0hmX/am3352-ddr-track-a-local-dfm-wip-20261007/docs/pcb-preview.png

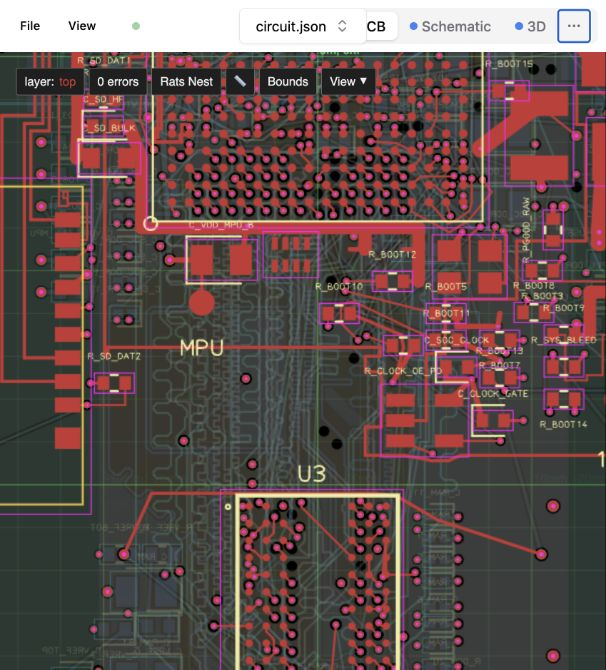
docs/pcb-preview.png
