0hmX/am3352-ddr-track-a-local-dfm-wip-20261007/README.md

# AM3352 DDR3 and RGB888 HDMI

This is a native tscircuit board with **251/251 named nets connected** (routing WIP; see limitations below). The active board is `index.tsx`; files in `layout/` and `data/` also include historical route sets, so presence does not imply a set is mounted. See the [251-net checkpoint](docs/routing-251-checkpoint.md), the prior [245-net checkpoint](docs/routing-245-checkpoint.md) and [validation summary](docs/routing-245-validation.json).

## Development

```sh
bun install --frozen-lockfile
bun run dev
```

Open `http://localhost:3020/#file=index.tsx&tab=pcb`. `bun run build` creates the site in ignored `dist/`. Functional subcircuit group boxes are organizational boundaries, not physical keepouts.

## DDR simulation

```sh
tsci simulate simulate.circuit.tsx     # or: bun run simulate
```

This runs the byte-0 DQ0 write simulation on the real board in about 4 minutes. It goes through FastHenry, FasterCap, the vendor IBIS models and ngspice, then writes the report, with the eye diagram, to `.tscircuit/simulation-simulate-<time>/results.html`. Open it and choose **Plots → Eye**.

**Before the first run,** place the two vendor IBIS files in `simulations-next/model-review/`: `sprm552c-candidate-models.ibs` (TI) and `W631GG6MB-12.ibs` (Winbond). They aren't distributed with this repo. Their source URLs and SHA-256 hashes are in `simulations-next/model-review/review-receipt.json`.

The result is DQ0 alone with an ideal strobe, not a byte-0 verdict. What is and isn't modeled: [simulations-next/README.md](simulations-next/README.md).

## Routing requirements and limitations

Keep processor and DDR memory placement fixed. Use actual component-pad-centered signal transitions and deliberate straight/45-degree routing. DDR point-to-point routes have at most two physical signal vias including endpoint escapes; ground stitches are separate. Preserve true pad positions and exact resistor-channel mappings. Bounded local spacing decisions do not waive physical shorts or same-depth drill clearance.

Validate the composed board with native continuity, clearance, placement and trace-style checks, then independently reparse emitted Gerber/Excellon connectivity, shorts, drill spans and reference coverage. Preserve prior connections and keep inherited findings visible.

All 46 DDR timing routes are connected, but 10 DDR reference-area findings and additional low margins remain. Board-wide via-in-pad compliance is incomplete: three signal midpoints and nine off-pad power joins remain. The actual fabrication stack, configured DDR rate, impedance, timing and current capacity are unverified. Filled/capped via-in-pad processing and blind/buried layer construction require fabricator qualification. RAM power retains capacitor-barrel dependencies. This is routing WIP, not a fabrication release or SI/PI/boot signoff.

The cloud checkpoint does not include offline Mac work. The prior [240-net snapshot](docs/routing-240-snapshot.md) is historical.

The SYSBOOT6 increment uses a reviewed V1V8 feed redistribution. Its capacitor-barrel dependencies remain open power-capacity limitations. See the current [routing TODO](docs/routing-todo.md).

SD clock relief: [native TSX detours and checks](docs/through-vias/sd-clock-relief-increment.md)
leave **572 non-through vias**; all 686 native connectivity entries remain connected.

CPU-area ground simplification: [four redundant pad barrels removed in native TSX](docs/through-vias/cpu-ground-pad-removal-increment.md)
leaves **568 non-through vias**, with unchanged trace copper and verified connectivity.

CPU-area ground links: [28 native surface links replace blind pad barrels](docs/through-vias/cpu-ground-surface-increment.md)
leave **540 non-through vias**, preserving every original trace centerline and verified connectivity.

CPU V3V3 feeds: [seven blind barrels replaced by native surface links](docs/through-vias/cpu-v3-surface-increment.md)
leave **533 non-through vias**; the C_IO1_0 bridge is retained and all connectivity checks pass.

DDR-area ground links: [seven blind pad vias replaced by native surface links](docs/through-vias/ddr-ground-surface-increment.md)
leave **526 non-through vias**, with fixed DDR placement and verified native/exported connectivity.

CPU surface ground: [checked native fills and 68 pad-via removal candidates](docs/through-vias/cpu-surface-ground-increment.md).
This groundwork retains **526 non-through vias**; actual removal is a separate stacked increment.

CPU pad-via removal: [68 blind barrels and 28 redundant ground links removed in native TSX](docs/through-vias/cpu-surface-pad-removal-increment.md)
leaves **458 non-through vias**, with all native/exported nets and post-drill ground terminals connected.

DDR surface ground: [native pours replace thirteen more blind pad vias](docs/through-vias/ddr-surface-pad-removal-increment.md)
leaves **445 non-through vias**; native and exported connectivity and actual post-drill ground continuity pass.

CPU auxiliary ground: [nineteen unused pad-free stitches removed in native TSX](docs/through-vias/cpu-aux-ground-removal-increment.md)
leaves **426 non-through vias**, with unchanged trace copper and verified connectivity.

DDR BGA escapes: [four nearby through columns with native TSX links](docs/through-vias/ddr-endpoint-nudges-increment.md)
leave **422 non-through vias**, preserving all original route centerlines and verified connectivity.

CPU peripheral ground: [wider native fills replace nineteen more blind pad vias](docs/through-vias/cpu-peripheral-pad-removal-increment.md)
leaves **403 non-through vias**, with unchanged trace copper and verified connectivity.

Ethernet relief: [ten auxiliary stitches removed and two endpoint barrels moved through in TSX](docs/through-vias/ethernet-through-relief-increment.md)
leaves **391 non-through vias**, with all original route centerlines preserved and connectivity verified.

DDR memory escapes: [DQS0 and BA2 gain through columns at memory in native TSX](docs/through-vias/ddr-memory-endpoints-increment.md)
leave **389 non-through vias**, preserving original route centerlines and verified connectivity; added lengths remain unqualified.

CPU pad columns: [24 native TSX through columns and short surface links](docs/through-vias/cpu-pad-through-columns-increment.md)
leave **274 non-through vias**, preserving all existing connections and fixed placements.

DDR_BA1 relief: [a native TSX through column with a 0.070711 mm nudge](docs/through-vias/ddr-ba1-through-column-increment.md)
leaves **273 non-through vias**, with all native/exported connections preserved.

CPU manual columns: [nine through vias and native power/USB links](docs/through-vias/cpu-manual-through-columns-increment.md)
leave **264 non-through vias**, with fixed placements and verified native/exported connectivity.

Peripheral pad columns: [27 native through columns and short surface links](docs/through-vias/peripheral-pad-through-columns-increment.md)
leave **237 non-through vias**, with fixed placements and all connections preserved.

DDR byte-1 relief: [two original CPU pad columns become through via a native Bottom detour](docs/through-vias/ddr-byte1-through-relief-increment.md)
leaves **235 non-through vias**, preserving both DDR paths and all connected nets.

Board surface Ground: [nine blind pad barrels removed with native surface fills](docs/through-vias/board-ground-pad-removal-increment.md)
leaves **226 non-through vias**, with all trace copper unchanged and connectivity verified after removal.
