0hmX/am3352-ddr-track-a-local-dfm-wip-20261007/docs/schematic-visual/before/cpu-power.png

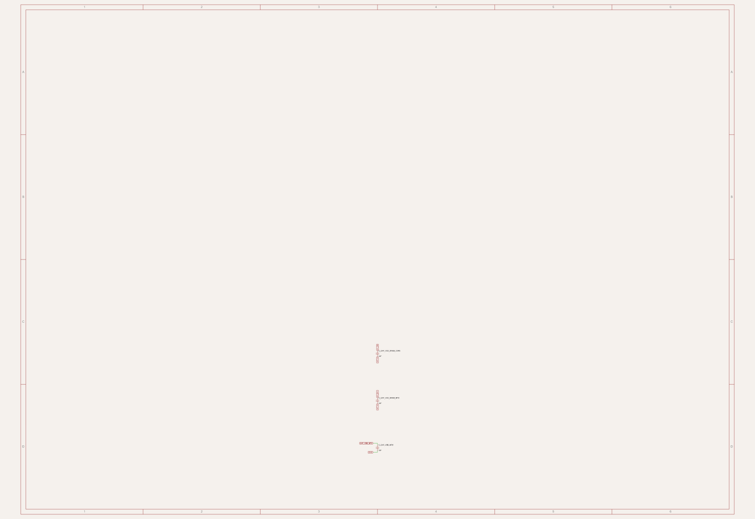
docs/schematic-visual/before/cpu-power.png
