0hmX/am3352-ddr-track-a-local-dfm-wip-20261007/docs/schematic-visual/before/ethernet-and-rgb-expansion.png

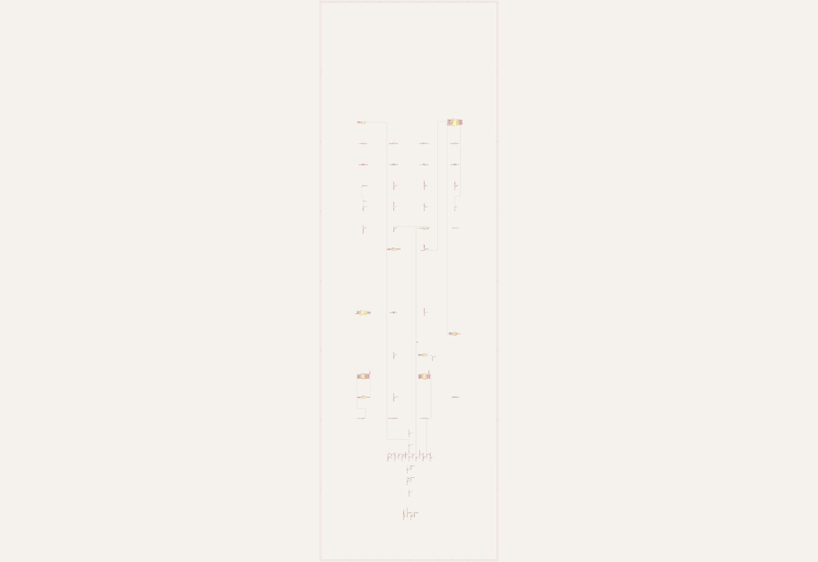
docs/schematic-visual/before/ethernet-and-rgb-expansion.png
