0hmX/am3352-ddr-track-a-local-dfm-wip-20261007/docs/schematic-visual/cpu-ddr/ddr-memory-address-and-control.png

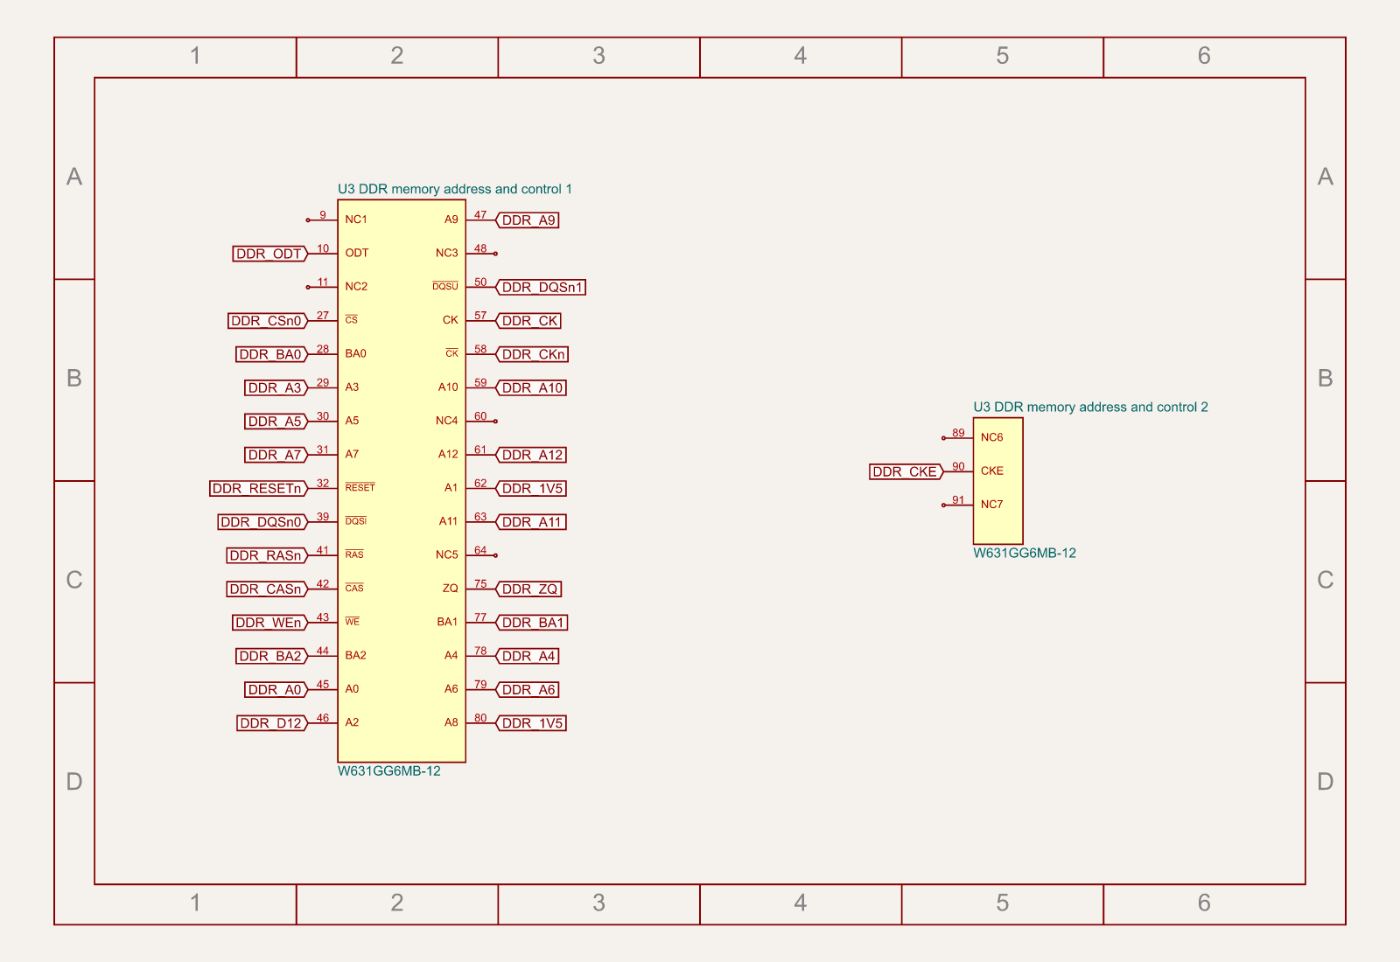
docs/schematic-visual/cpu-ddr/ddr-memory-address-and-control.png
