0hmX/am3352-ddr-track-a-local-dfm-wip-20261007/docs/schematic-visual/power/power-management.png

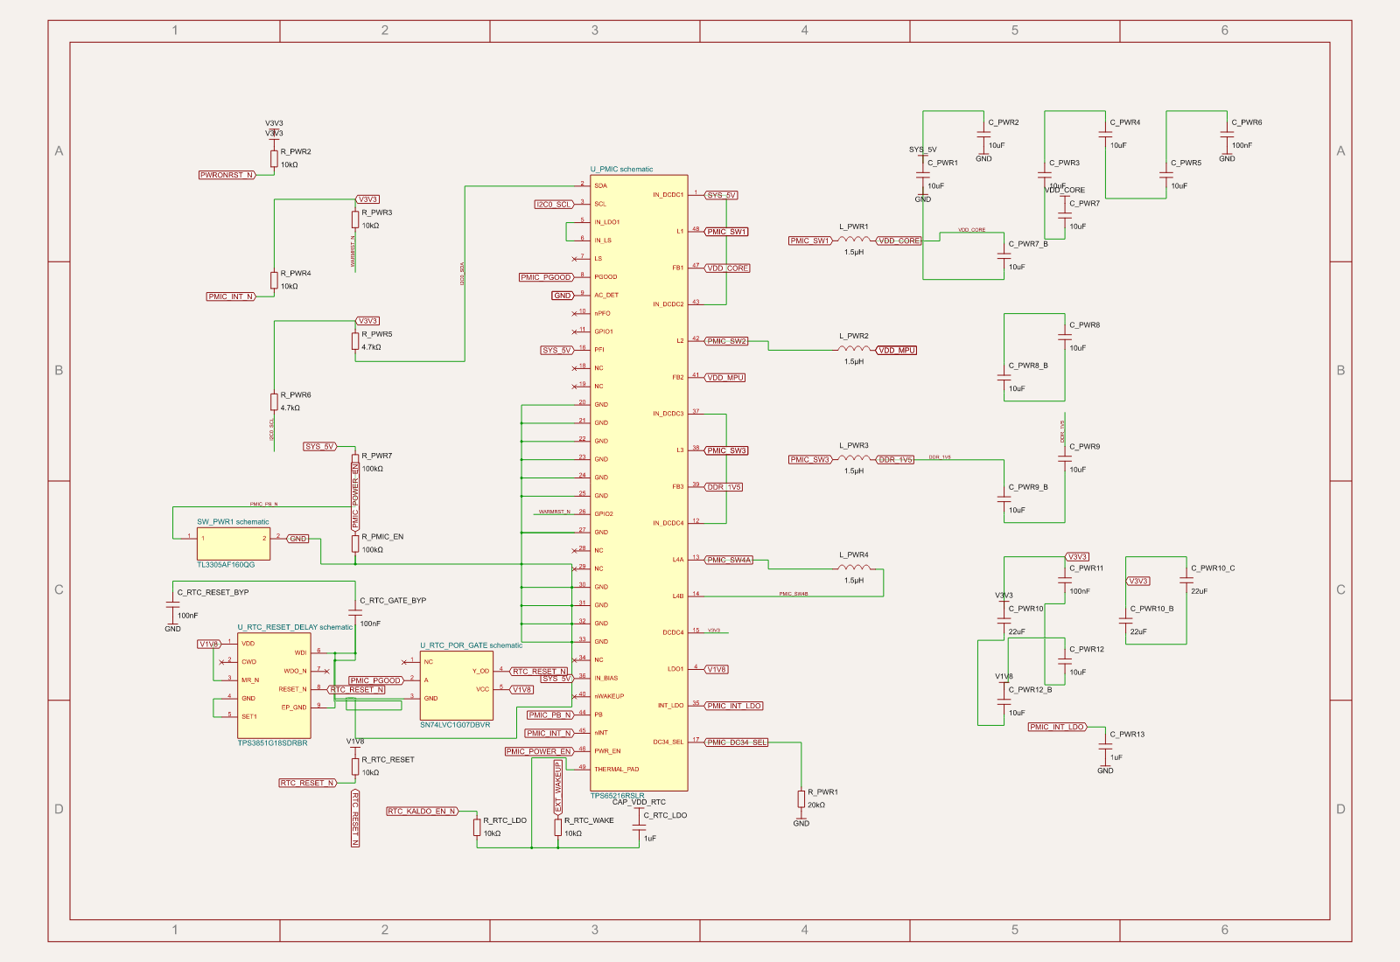
docs/schematic-visual/power/power-management.png
