0hmX/am3352-ddr-track-a-local-dfm-wip-20261007/models/kicad/BGA-324_15.0x15.0mm_Layout18x18_P0.8mm_Ball0.5mm_Pad0.4mm_NSMD.step

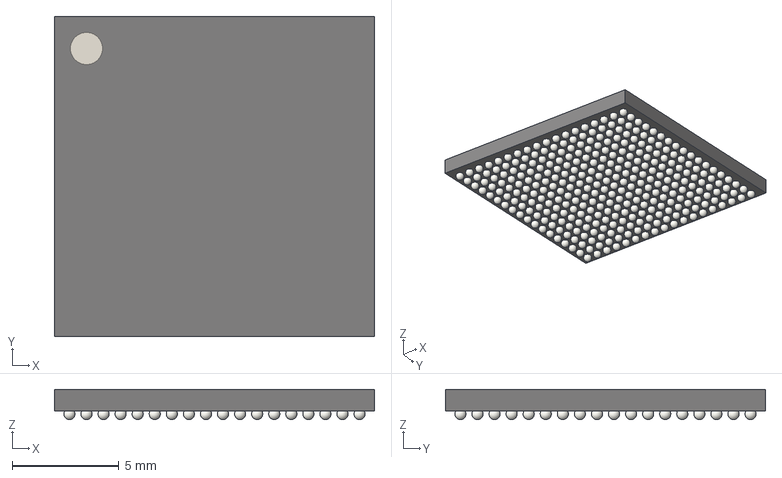
[picture p15: CAD file, 2026-11-06]
models/kicad/BGA-324_15.0x15.0mm_Layout18x18_P0.8mm_Ball0.5mm_Pad0.4mm_NSMD.step
15.0 x 15.0 x 1.41 mm
