0hmX/am3352-ddr-track-a-local-dfm-wip-20261007/(list of files, drawings)

Other design files:
docs/schematic-lint/boxes/pcb-source-fingerprints.json
docs/schematic-visual/before/pcb-source-fingerprints.json
