0hmX/am3352-ddr-track-a-local-dfm-wip-20261007/(commit log)

2026-10-27 Publish checked AM3352 DDR3 and HDMI board snapshot
2026-10-27 Preserve routed AM3352 board in TSX
2026-10-28 Save routing checkpoint and update tscircuit
    Add validated native ground and DDR power feeds, plus unmounted routing candidates with documented conflicts. Add board-wide validation with optional baseline comparison and update tscircuit/core to 0.0.3033/0.0.2225.
2026-10-30 Expose main board and subcircuits in preview
2026-11-02 Add bounded simulation diagnostics and incomplete-board guard
2026-11-02 Advance verified AM3352 routing checkpoint to 244 connected nets
    Import the tested runtime/source delta from local checkpoint a96772d3de9d3d049a4ac00c8e1cde366c3d8803. Preserve the current PGOOD repair and DDR route lengths, layer assignments and 68 centered signal vias. Add concise public validation and open-work notes; exclude private reports, logs and agent files.
    Fresh combined native and exported-copper checks retain all prior connections. Seven nets, 13 DDR reference findings and documented via/PDN/timing limitations remain. Keep the pull request draft.
2026-11-02 Route SYSBOOT6 through real pads; record 245-net validation and power limits
2026-11-04 Route HDMI_D0 and HDMI_D8 (U_HDMI to RN_HDMI_1) on inner4/inner5
    Pad-centered vias at both terminals, 0.1 mm traces, new file
    layout/CloudHdmiD0D8Routes.tsx mounted in index.tsx. Validation: no new
    failures vs baseline, no shorts, no previously connected net lost.
2026-11-04 Write new route geometry as native TSX instead of JSON imports
    Inline HDMI_D0/D8 vias and traces in CloudHdmiD0D8Routes.tsx and drop
    data/cloud-hdmi-d0-d8-routes.json. Restore the original SYS6 JSON and put
    the rerouted SYS6 pull-to-CPU path inline in CloudSys6RealTerminalRoutes.tsx.
    Compiled copper geometry is identical to the validated merge.
2026-11-04 Remove Python from build and dev; use plain tsci
    scripts/build.sh and scripts/dev.sh ran scripts/mirror-source.py, which
    needs python3 (absent in the tscircuit.com build sandbox). tscircuit.config.json
    already limits board files to index.tsx, so build and dev now call tsci directly.
2026-11-04 Move J_ETH flush to board right edge (pcbX 50.31) and reroute its attached traces
2026-11-04 Move J_HDMI so PCB Edge line sits on board edge (pcbX 64.625 -> 62.975) and re-route affected nets
2026-11-04 Move J_POWER flush with board edge (pcbY 22.825) and reroute affected copper
2026-11-04 Document connector edge alignment
2026-11-04 Run the DDR simulation on the native TSX board
    Remove the saved-board ImportedBoard bridge. ibis.circuit.tsx renders the
    real board from index.tsx with its simulation declarations as children, and
    selects U1/U3 pins through their Processor and DDR3 subcircuits. The board
    is compiled once beforehand only to resolve the routed DQ/DQS pads. The HDMI
    SPICE-subcircuit filter existed only for the bridge.
    Pin tscircuit 0.0.3082 (CLI with pcb-spice-pipeline 0.1.6) and
    @tscircuit/core 0.0.2268. Needs tscircuit/core#5155 to render.
2026-11-05 Add product assembly, 3D models and a USB-A host port
    - assembly.tsx: <assembly.device> with the unchanged board, a generated
    <enclosure.fdm.box> (base + lid, 4mm standoffs) and an assembly drawing page.
    The board is re-expressed as the same 98x65.5mm rectangle centred on its
    outline so the enclosure lands on it; no copper moves.
    - models/: KiCad 10 STEP models for every custom footprint (82 parts), plus
    two generated GLB bodies for parts KiCad does not model (RJ45, RSV UQFN-16).
    - Enclosure openings declared per connector (USB-C, USB-A, HDMI, RJ45,
    microSD, two tact switches) and lid windows over the AM3352 and DDR3.
    - USB1 host port: Molex 67643 USB-A, TPS2051B always-on VBUS swi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
2026-11-05 Show mating HDMI, USB-A and USB-C cables in the 3D assembly
    The ports were modelled but nothing was plugged into them. Add three
    <assembly.part> cable plugs (assembly view only, no BOM/PCB effect) whose
    shells sit in the J_HDMI, J_USB_HOST and J_POWER socket mouths, with the
    overmold starting outside the enclosure wall. Plug bodies are dimensioned
    GLBs from scripts/generate-cad-bodies.ts (HDMI-A 13.9x4.45, USB-A 12x4.5,
    USB-C 8.25x2.4 shells).
2026-11-05 Drop the USB-A host port; USB-C stays the only USB port
    Remove the USB1 host connector, switch, ESD and caps, their routes, the
    USB1 ball net assignments, the USB-A model/cutout and the USB-A cable plug.
    index.tsx, logic/connections.tsx and subcircuits/index.tsx are back to main,
    so board copper is unchanged from main; verify-board-routing findings are
    identical to main (20 + 3 inherited via-spacing, no shorts, no unconnected).
2026-11-06 Two USB-C ports: USB PD power input and a USB0 programming port
    J_POWER (power): replace the TUSB320LAI current detector with an Infineon
    EZ-PD BCR CYPD3177 PD sink set for a fixed 5 V / 3 A contract (VBUS_MIN =
    VBUS_MAX = 5 V, ISNK 3 A per datasheet Tables 2-4). Its VBUS_FET_EN
    ("contract within range") drives the existing TPS259531 eFuse EN through
    the SN74LVC1G98, re-strapped as an inverter. SYS_5V stays 5 V.
    J_USB_PROG (programming/data): new GCT USB4105 in the top-left corner on
    AM3352 USB0 (DP N17, DM N18, VBUS P15 sense) with 5.1k Rd on CC1/CC2 and
    an ESD204 on D+/D-. USB0 ROM boot covers flashing; Linux gadget mode
    covers serial/ethernet afterwards. The port never powers the board.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
2026-11-06 Simulate DQ0 through the straightened-stages reduction
    Adds lanes/pcbSpiceChannel options to DdrIbisBoard; IBIS-bound pins outside
    the simulated lanes are idle receivers. run-dq-stages models DQ0 (top layer,
    no vias) over the inner1 GND plane from the board stackup.
2026-11-06 Derive the DQ0 straightened-stages return from the board stackup
    stage-profiles.tsx builds the return bar from pcb_stackup and the GND pours
    (nearest ground layer, its thickness, the dielectric between) instead of
    hand-typed numbers, and rejects layers between two ground planes (#50) and
    lanes that change layer (#49). Same extraction as before: R 0.410029 ohm,
    L 10.1776 nH, C 3.3202 pF. README documents the run and its limits.
2026-11-06 Add a one-command DDR simulation entry
    tsci simulate simulate.circuit.tsx (or bun run simulate) runs the byte-0
    DQ0 write simulation on the real board and writes the eye-diagram report to
    .tscircuit/simulation-simulate-<time>/results.html. README documents the
    run and the vendor IBIS files it needs.
2026-11-06 Use the latest tscircuit; let the pipeline derive DQ0's return
    - tscircuit 0.0.3104 and core 0.0.2287; CLI 0.1.2443 bundles
    pcb-spice-pipeline 0.1.8. Both core copies now include the subcircuit and
    schema fixes, so the overrides entry is dropped.
    - Pipeline 0.1.8 builds straightened-stages returns from pcb_stackup
    (tscircuit/pcb-spice-pipeline#55), so the board's hand-written top profile
    and stage-profiles.tsx are removed. Same geometry and result.
    - The DQ-only entry runs one experiment: without simulated DQS lanes the
    quiet and switching-strobe cases are identical.
2026-11-09 Extend processor and DDR ground-pad vias through all eight layers
2026-11-09 Port the two affected JSON-fed ground returns into native TSX
2026-11-09 Convert Ethernet ground pads and nudge three stitches for through vias
2026-11-09 Convert HDMI ground pads to through vias and remove span overrides
2026-11-09 Convert power-area ground and core-power vias with preserved Inner5 ports
2026-11-09 Record post-drill reference gaps and reproduce validator success on lost continuity
2026-11-09 Convert nine ground stitches and reject lost physical connectivity in validation
2026-11-09 Port local-control endpoints and microSD debug ground pads to through vias
2026-11-09 Port four strap reference vias and document rejected V3V3 cuts
2026-11-09 Reroute wakeup to clear five native DDR support and ground through vias
2026-11-09 Remove four DC-redundant native ground pad barrels
2026-11-09 Replace 28 CPU-area blind ground vias with native surface links
2026-11-09 Compact generated native ground-link visualization
2026-11-09 Replace seven DDR-area blind ground vias with native surface links
2026-11-09 Add checked CPU surface ground coverage before pad-via removal
2026-11-09 Remove 68 CPU-area blind pad vias using checked surface ground
2026-11-09 fix: replace thirteen DDR blind pad vias with surface ground
2026-11-09 fix: remove nineteen DC-redundant CPU ground stitches
2026-11-10 fix: replace nineteen peripheral CPU blind ground pad vias
2026-11-10 fix: remove ten Ethernet ground stitches and move two endpoints through
2026-11-10 Remove redundant HDMI and control Ground stitches
2026-11-10 Replace 20 HDMI Ground pad vias with native surface copper
2026-11-10 Replace 19 Ethernet Ground pad vias with native surface copper
2026-11-10 Replace five DDR power pad barrels with native surface feeds
2026-11-10 Replace seven PMIC Ground pad vias with native surface copper
2026-11-10 Move 24 CPU power and Ground pad vias into through columns
2026-11-10 Move nine CPU manual vias through with native power and USB routes
2026-11-10 Move 27 peripheral power and Ground pad vias through in native TSX
2026-11-10 Replace nine blind Ground pad vias with native board surface copper
2026-11-10 Clear four power and boot through columns with native trace detours
2026-11-10 docs: record schematic placement lint baseline
2026-11-10 fix: resolve all 52 schematic box lint findings
2026-11-10 fix: compact CPU and DDR schematic passive banks
2026-11-10 fix: place power boot and debug schematic support networks
2026-11-10 fix: clear remaining interface schematic placement lint
2026-11-10 fix: compact power management schematic with native local wires
2026-11-10 docs: verify power schematic PCB equivalence and visual metrics
2026-11-10 fix: compact CPU and DDR schematic views and supply buses
2026-11-10 fix: avoid duplicate-port schematic bus merges in browser
    Keep the original CPU/DDR pin-to-net declarations, retain compact views,
    and reproduce the renderer's overlapping connectivity-list failure in TSX.
    Correct Power/CPU/DDR placement findings and record browser, lint, PCB and
    connectivity verification with refreshed full-board visual evidence.
