0hmX/am3352-ddr-track-a-local-dfm-wip-20261007/(notices)

Notices in the files:
models/kicad/BGA-324_15.0x15.0mm_Layout18x18_P0.8mm_Ball0.5mm_Pad0.4mm_NSMD.step:
Copyright (C) 2026, KiCAD
This work is licensed under the
[Creative Commons CC-BY-SA 4.0 License](https://creativecommons.org/licenses/by-sa/4.0/legalcode),
with the following exception:
project files under this or any other license agreement. However, if you wish to distribute
